uwo-fast/OpenReactor/(commit log)

2021-07-27 updated README for raspberry pi stuff
2021-07-27 Added test.py, a temporary file to test the i2c library.
2021-07-27 created test scripts for reading sensors
2021-07-28 added print functions and then some sensor class testing
2021-07-28 testing db connections half fix
    [sensor.py]
2021-07-29 FIrst fix to graphs, basic functionality added
    [app.py]
2021-08-11 added cad to repo, setup script, updated readme
    [coolingBracket.scad, gasRelease.scad, lid.scad]
2021-08-13 Added cad
    [coolingBracket.scad, coolingBracket.stl, gasRelease.scad, gasRelease.stl]
2021-08-13 rewrote tube connection nipple funciton using bosl
    [gasRelease.scad, gasRelease.stl, lid.scad]
2021-08-14 Graphs can now be added to the graphing page using a button, added new functions in app.py to achieve this and rewrote essentially all of graphs.html.
2021-08-17 updated cad
    [lid.scad, lid.stl, nipple.scad, old_lid.scad]
2021-08-26 Started working on adaptive control code, partially working but had issues with database.
    [app.py, sensor.py]
2021-09-13 Added threading to lib, first design for one way gas release valve
    [holderCylinder.stl, lid.scad, lid.stl, release.stl, threadtest.scad]
2021-09-15 Changed pathing for 'model' hopefully to avoid issues with local imports, removes compatability with windows systems due to requirement of sensor.py
    [app.py, sensor.py]
2021-09-26 Remade the gas release valve.
    [lid.scad, release.stl]
2021-10-01 Added truncation to the floats passed to control interface -May consider adding this to any data retrieval from db to reduce json size if that becomes an issue
    [app.py]
2021-10-19 Pushing local edits, fixing file pathing still
    [app.py, sensor.py]
2022-01-18 Added built in detection of connected I2C devices on launch, started work on integrating measurements and control systems.
2022-01-18 Fixed some issues with control, still need to fix CSS and live updating for control mechanisms
    [app.py]
2022-02-01 Fixed format and functionality of controls page, control states now write correctly to DB Please enter the commit message for your changes. Lines starting
    [app.py, device_detect.py, sensor.py, sensor_format.py]
2022-02-21 Added PCB file for multispectrum LED
    [laser.kicad_pcb, laser.kicad_sch, multispectrum LED.kicad_pcb, multispectrum LED.kicad_sch, relay.kicad_pcb, relay.kicad_sch]
2022-02-23 Added second current source and breakout for laser. Need to switch outputs of relays.
    [relay.kicad_pcb]
2022-02-28 updated PCB for relay
    [relay.kicad_sch]
2022-03-06 First Version of Optical Density source finished, swithced to a pin out connection for multispectrum LED.
    [laser.kicad_pcb, laser.kicad_sch, multispectrum LED.kicad_sch, relay.kicad_pcb, relay.kicad_sch]
2022-03-10 Completed implementation of cycle control, experiments can now be created, started, stopped, downloaded, and deleted entirely from the web UI. Experiments are defined as JSONs that contain a name, st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
2022-03-12 Improved documentation & layout
    -Fixed some issues that arose with graphing due to experiment selection
    -Began to properly document both front and backend code.
    -Changed order of navbar links
    [app.py, sensor.py]
2022-05-23 Implemented Threading for data aquisition Combined data aq. with existing experiment cycle Added tables to db for controls TODO ------- Fix control landing page, due to changes it doesn't load atm Im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
    [app.py, cycle.py, device_detect.py, sensor.py, sensor_format.py]
2022-05-24 Reworked structure of database for controls. Now has ControlReadings. Everything beyond if it's enabled and it's value are stored as a json in the db. Fixed controls html, now displays all controls a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
    [app.py, device_detect.py, sensor.py]
2022-06-01 Fixed issue with loading entire db table that caused massive lag. Fixed updating of user values in interfaces.
    [app.py, sensor.py]
2022-06-01 Started device config for JSON
2022-06-01 Adding Basic documentation First attempt at setup for BREAD Slice - Relay Heating Element Controller
2022-06-22 Added param for byte type to sensor.controlMessage, added outputType to __init__ of control functions
2022-06-23 Added traceback to threading try/except loop
2022-06-23 possible fix, may just break other things
    [sensor.py]
2022-06-23 updated motor II code to match I
2022-06-23 Removed legacy openSCAD files
    [coolingBracket.scad, coolingBracket.stl, gasRelease.scad, gasRelease.stl, holderCylinder.stl, lid.scad, lid.stl, nipple.scad]
2022-06-26 First attempt at getting control systems to reset to initial paramters on shutdown/disable
    [app.py]
2022-06-28 possible fix to experiment stop
    [app.py]
2022-07-29 Added experiment thread cycle time management
2026-10-03 chore: rename the project from Loafware to OpenReactor (#3)
    The repository is now uwo-fast/openreactor. Replace the Loafware name
    in the README, the web interface (page title, navbar, landing page,
    about page), the npm package metadata and the LICENSE notice.
    The README's install steps and the about page linked to
    github.com/FEASTorg/loafware, which does not exist; they now point to
    this repository. The about page's first paragraph also lost the words
    "written in" before its list of libraries; they are restored.
    The database file keeps its name, loafware.db, so an existing install
    keeps its data after updating. A comment in config.py records why.
2026-10-03 fix(sensors): timestamp control parameter edits and resets (#4)
    I2C.edit_params() and reset_control() stored the new parameters with
    self.time, which only controlMessage() updates. So an edit was stored
    with exactly the timestamp of the row before it. The control plugins
    read their current parameters with ORDER BY time DESC, and SQLite
    does not define which of two tied rows that returns, so a change made
    from the web interface could be ignored.
    It could also undo changes to closed-loop controls: the heater and pH
    PID plugins call edit_params() from process(), so on a tie they could
    read the old parameters and store them back over the change.
    Both methods now take a fresh timestamp before s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
    [sensor.py]
2026-10-03 feat(controls): apply safe control changes immediately (#5)
    A change posted from the web interface used to be stored and then
    wait for the next experiment-thread cycle, or forever if no
    experiment was running. It is now sent to the slice straight away
    when that is safe:
    - Disabling a control always resets it at once, so switching off a
    heater or pump takes effect even with no experiment running.
    - Enabling or retuning a control applies at once only if its plugin
    sets APPLY_ON_CHANGE = True. The two motor plugins do, as their
    output is just the requested speed. The heater and pH PID plugins
    do not: they integrate on every call and need fresh sensor readings,
    so they stay with the e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
    [device_detect.py, sensor.py]
2026-10-03 fix(sensors): read the whole EZO reading (#7)
    The "atlas" formatter kept only the four characters after the status
    byte, so every EZO reading longer than four characters was cut short:
    7.012 became 7.01, -123.4 became -123, and an EC reading of 12880
    became 1288, ten times too small.
    It now takes the leading number after the status byte. That stops at
    the NUL terminator, at any padding after it, and at the comma when a
    multi-output circuit such as EC sends several values, of which the
    first is the primary reading.
    [sensor_format.py]
2026-10-03 fix(maths): stop the calibration parser from hanging (#8)
    The parser turns implicit multiplication such as 2x or 2(x+1) into
    2*x and 2*(x+1), but its regular expressions only matched the digits
    1-9 before x or "(". A coefficient ending in 0 was left as "10x":
    10x+0, 20x+1 and 0x+7 hung forever, and 100x, 10(x+1) and 1.50x
    raised errors. Both expressions now match any digit.
    Other input the solver could not reduce also hung it, including
    equations with spaces (2x + 1) and malformed ones such as 2x2 or
    x+-1. Spaces are now removed before parsing, and a pass over the
    equation that changes nothing raises ValueError instead of looping.
    The hang mattered most because readings are calibrated whil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
2026-10-03 fix(app): hold dataLock for control changes and manual reads (#9)
    The experiment thread holds dataLock for each cycle, but the routes
    that change control state or use the bus did not take it:
    - A parameter change posted from the controls page could land while
    a heater or pH PID plugin was between reading its parameters and
    storing them back, and the plugin then wrote the old parameters
    over the change.
    - The Reset button changed parameters the same way.
    - A manual sensor read could use the bus during a cycle.
    These routes now hold dataLock, and applyControlChange() expects its
    caller to hold it. A change may now wait for the current cycle to
    finish.
    Stopping an experiment had a rela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
2026-10-03 fix(app): make Reset and Stop reach the outputs (#10)
    The Reset button restored each control's default parameters in the
    database but never wrote to the bus. With no experiment running, a
    heater or pump kept its last output after Reset. Reset now applies
    the reset to each control straight away, under dataLock, by the same
    rules as a change from the controls page: a disabled control gets its
    reset output, and an enabled closed-loop control is left to the
    experiment cycle.
    Stopping before any experiment had started raised AttributeError,
    because the initial thread handle was a threading.Thread, which has
    no cancel(). Pressing End in that state returned an error and left
    the outputs as they we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
2026-10-03 fix(sensors): ignore EZO responses without a new reading (#11)
    The "atlas" formatter never looked at the EZO status byte. If a
    "still processing" response (254) carried text, such as the previous
    reading left in the buffer, that text was stored as a new reading.
    "No data" (255) and "syntax error" (2) produced text that failed to
    convert and was dropped with an error.
    Only status 1 (success) now yields a reading. Anything else prints
    the status and returns None, which store() already skips. The status
    byte is masked like the text bytes, so a success byte with the high
    bit set still counts.
    [sensor_format.py]
2026-10-03 fix(maths): compute calibration equations correctly (#12)
    The hand-written equation solver got several kinds of equation wrong:
    - It did every addition before any subtraction, so x-1+2 was
    computed as x-(1+2).
    - A number minus x was treated as x minus the number: 3-x gave x-3.
    - A number divided by x was treated as x divided by the number,
    though it is not a linear calibration at all.
    - A leading minus (-2x+3, -x) raised an error.
    parse() now reads the equation with Python's own expression parser
    and evaluates it as a linear function m*x + b. It allows numbers, x,
    + - * /, unary minus and brackets, with implicit multiplication such
    as 2x, 2(x+1), x(2) and (x+1)2. Input longer than 100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
2026-10-03 fix(app): reject calibration equations that do not parse (#13)
    /controls/calibrate saved whatever text it was sent. An equation the
    parser could not use (x*x, x/0, abc) was stored and then failed on
    every reading of that sensor, and a constant such as 5 was accepted
    although it would replace every reading with that constant.
    The route now parses the equation first and saves it only if it
    evaluates to a number with x as the variable and depends on x.
    Otherwise it returns 400 and keeps the previous equation, and the
    settings dialog shows "Invalid equation, not saved" instead of
    closing. The dialog also gains a Cancel button, since a successful
    save was the only way to close it.
2026-10-03 fix(app): run only one experiment loop at a time (#14)
    Starting an experiment while one was already running started a
    second timer loop, so every cycle then ran twice, reading every
    sensor and writing every control twice as often. A related race let a
    cycle from a stopped loop keep going: if its timer had already fired
    and was waiting for dataLock when Stop and a new Start came in
    quickly, it ran alongside the new loop and rescheduled itself.
    experimentThreadStart() now does nothing if a loop is already
    running, and checks and starts under dataLock. Each start also bumps
    a loop generation that its cycles carry, and a cycle from an older
    generation returns without doing anything. The experim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
2026-10-03 build(deps): update the web stack and drop unused packages (#15)
    requirements.txt pinned the 2021 releases of Flask 2.0.1, Werkzeug
    2.0.1, Jinja2 3.0.1 and wheel 0.36.2, which all have published
    security advisories. The Werkzeug fixes are only in 3.x, which needs
    Flask 3, so the web stack moves to current releases: Flask 3.1.3,
    Werkzeug 3.1.9, Jinja2 3.1.6, MarkupSafe 3.0.4, itsdangerous 2.2.0,
    click 8.1.8 and blinker 1.9.0, which Flask now requires. All support
    Python 3.9 and later; click stays on 8.1 because 8.2 needs 3.10. On
    Python 3.9, Flask also needs importlib-metadata, which brings in
    zipp; both are pinned for that version only.
    The app only uses Flask, render_template, request and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
2026-10-04 fix(experiments): stop shipping a running sample experiment (#30)
    experiments/test.json was a sample experiment saved with "running": 1.
    At startup the app resumes every experiment marked running, so every
    fresh install started the experiment loop on import, recording to an
    experiment nobody had created.
    The file is removed, so a fresh install starts idle, and experiment
    records written at runtime (experiments/*.json) are now ignored by git
    so one cannot be committed again.
2026-10-04 feat: replace the 1.x code with the 2.0 config and CLI (#36)
    Remove the 1.x application from main: app/, sensors/, controls/,
    database/, experiments/, run.py, config.py, requirements.txt,
    first_time_setup.sh, start.sh and devices.json. It stays on the 1.x
    branch and its tags.
    Add the TOML configuration model (stdlib tomllib). Validation rejects
    duplicate bus and address pairs, unknown kinds, addresses outside 0x08
    to 0x77, a name used twice (device and channel names share one
    namespace, since an EZO device is itself a channel), a temp_comp that
    does not name an ezo-rtd device, a watchdog timeout outside
    3 x slice_poll_s to 65535 ms, and an ezo_period_s below the slowest
    EZO read plus 0.2 s.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
    [device_detect.py, sensor.py, sensor_format.py]
2026-10-04 ci: publish releases to PyPI with Trusted Publishing (#38)
    A v* tag that matches the pyproject.toml version builds the wheel and
    sdist, publishes them from the pypi environment with Trusted
    Publishing (no API token), then creates the GitHub release with the
    distributions and a constraints.txt from uv.lock. Versions with a, b
    or rc are marked as pre-releases.
    Running the workflow by hand dry-runs the same build against TestPyPI
    from the testpypi environment.
    Part of #20.
2026-10-04 build: allow uv_build 0.12 (#37)
    Widen the build backend pin from >=0.11,<0.12 to >=0.11,<0.13.
2026-10-04 build: pin uv to the uv_build range in CI and locally (#39)
    setup-uv installed the newest uv (0.12.23 for v2.0.0a1), which built
    with its own backend although build-system.requires said
    uv_build<0.12, and only warned. setup-uv reads tool.uv.required-version
    from pyproject.toml, so CI now installs the newest uv inside the same
    range as the build backend, and a local uv outside it refuses to run.
2026-10-04 feat(ezo): read and calibrate EZO circuits from the CLI (#40)
    Add the Atlas EZO pH, ORP, RTD, EC, DO and HUM circuits over
    ezo-driver, behind a small EzoPort protocol so tests can use a fake.
    - At startup each circuit's reported type is checked against the
    config, and the output masks of DO, EC and HUM and the RTD scale are
    cached. A circuit of the wrong type is disabled and reported.
    - Reads are split-phase: every read is sent, then each circuit is read
    when its own delay is up. pH, EC and DO compensate with the last RTD
    temperature, converted to Celsius; a failed RTD read, or the RTD's
    no-probe value of -1023, clears it, and the reading says so. A
    NOT_READY circuit is read aga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
2026-10-04 feat(controller): one bus owner with a tick, stop-all and a lock (#41)
    Add the controller every device command goes through:
    - A 100 ms tick on a monotonic clock, at start + n x 100 ms so it never
    drifts. A tick never sleeps or waits on a device: it drains a command
    queue, resumes EZO commands that are due, and starts and collects the
    split-phase EZO reads.
    - Stop-all runs on the next tick and sends every actuator its safe
    state before reporting anything; a failing actuator, a failing
    listener or an interrupt never skips the others, and listener errors
    are isolated. The slices add actuators in #24 and #25.
    - EZO commands are step generators the controller resumes on later
    tick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
2026-10-04 docs(bench): prepare a Pi for the bench checks (#42)
    How to enable I2C, switch the EZO circuits to I2C mode and find them at their default addresses, install from a checkout while ezo-driver builds from source, check a config, and check that the controller lock holds across users.
2026-10-04 feat(storage): record runs, readings and events in SQLite (#43)
    - A Store over stdlib sqlite3 in WAL mode, with the schema version in
    PRAGMA user_version; another version is refused. Tables: channels,
    runs (running, completed, stopped or interrupted, with a config
    snapshot), readings (each with its unit), events and profiles. The
    schema is created under BEGIN IMMEDIATE, so first opens do not race.
    - A Recorder subscribed to the controller writes on its thread, the
    database's only writer. Each reading is one transaction; failed reads
    and non-finite values become events. While recording, a write waits
    at most 50 ms for a lock. A failed write is logged, stops recording
    and marks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
2026-10-04 feat(web): serve the controller over an authenticated HTTP API (#45)
    openreactor serve runs the controller in a FastAPI app's lifespan, one
    process and one worker, holding the controller lock and binding the
    port before any device opens. /api/v1 covers status, channels,
    setpoints (409 until the slices land), stop-all, runs and export, and
    EZO calibration, through a service layer that never touches the bus.
    A timed-out action is cancelled, never run late; circuit refusals are
    502 and storage failures 503.
    Without server.password_hash, serve binds only to loopback and answers
    only loopback Host names. With one, a browser signs in at POST /login
    for a revocable signed session cookie and a scri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
2026-10-04 fix(serve): exit cleanly on Ctrl-C (#46)
    uvicorn re-raises Ctrl-C after a clean shutdown; serve, which calls Server.run itself to bind the port first, let the KeyboardInterrupt through as a traceback and exit 130. It now exits 0.
2026-10-04 build(deps): take ezo-driver 0.6 from PyPI (#49)
    ezo-driver 0.6.0 is on PyPI with cp39-abi3 wheels for x86_64 and aarch64; the git pin goes, capped below 0.7, and a Pi installs with no compiler. Tested wheel-only (uv sync --no-build-package ezo-driver): 326 passed.
2026-10-04 feat(ui): serve an operator UI that works offline (#50)
    openreactor serve now serves the operator's UI at /: server-rendered
    Jinja2 pages with htmx partials. A dashboard with live values and a
    chart per channel (a gap for a failed read), controls with a setpoint
    per actuated channel, runs (start, stop, export), EZO calibration with
    Calibrate and Clear behind a confirmation, and an about page with the
    AGPL notice and the vendored packages. Stop all is on every page, and a
    stop-all where any output failed shows as a red failure naming it. The
    footer gives the version and the source link.
    Pages and actions use the same service layer and sign-in as /api/v1:
    pages send a stranger to a sign-in fo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
2026-10-04 feat(rlht): start RLHT slices safely and keep their watchdog fed (#52)
    run and serve start each RLHT heater slice over CRUMBS (crumbs-i2c
    0.15, bread-crumbs-contracts 0.5); read and ezo cal never touch one.
    Start-up checks the reply's type, CRUMBS 0.12.0 or later and the
    module version, reads caps, sends the safe state (SET_SETPOINTS(0, 0)
    then SET_OPEN_DUTY(0, 0), both always), arms and confirms the command
    watchdog when the slice has one (read-only otherwise, unless
    allow_unprotected), then sets closed-loop mode, the thermocouples and
    any configured periods and gains.
    Gains are never filled in: check-config takes kp, ki and kd only on a
    channel for each output or on none, and refuses ki =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
2026-10-04 feat(rlht): supervise slices for trips, reboots, e-stops and silence (#54)
    ## Description
    This is the second of three parts of #24. A running RLHT slice is
    supervised: openreactor notices a watchdog trip, a reboot, an e-stop or
    a silent bus, logs it, and puts the slice back the way the config and
    the operator left it. Setpoints from the API and UI follow in part 3.
    **The cycle.** Each `slice_poll_s` slot reads GET_STATE, split across
    two ticks so a tick never waits. After every fifth state poll, the same
    cycle also reads GET_WATCHDOG on the next tick.
    **Trips and reboots.**
    - A reboot is the watchdog reading disarmed.
    - A trip is the tripped flag, or a trip count that changed. A count
    bel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
2026-10-04 feat(rlht): set slice setpoints from the API and the controls page (#56)
    Part 3 of #24, first half: an operator can now set an RLHT channel's
    setpoint. A follow-up PR adds `openreactor status`.
    **Setting it.** `PUT /api/v1/channels/<name>/setpoint` or the Controls
    page. The value is in °C, rounded to the slice's tenth of a degree, and
    goes to the slice at once from the controller's thread. It becomes the
    desired setpoint, which a re-assert sends again, only once the slice has
    it. Stop-all or an e-stop zeroes it, and a restart never restores it.
    Each setpoint sent or tried is an event in the run.
    **Refused, with nothing sent:**
    - **422:** below 0, not a JSON number (`true`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
2026-10-04 feat(cli): show each RLHT slice's state with openreactor status (#57)
    Part 3 of #24, second half: `openreactor status` shows each RLHT slice's
    state.
    ```
    $ openreactor status
    heater 0x0A RLHT 1.0.0, CRUMBS 0.15.0
    watchdog armed 5000 ms, trips 0
    e-stop clear
    mode closed loop
    jacket 37.4 °C setpoint 37.0 duty 22 % tc 1
    output 2 no reading setpoint 0.0 duty 0 % tc 2
    (from the server at http://127.0.0.1:8080/api/v1/status)
    ```
    **Only from a running server.** status asks the server's
    `/api/v1/status`, at the config's `[server]` address or `--url`. A
    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
2026-10-04 docs(readme): say which slice firmware stop-all turns a heater off on (#58)
    The README said stop-all decays a running heater "until
    feastorg/Slice_RLHT#13 is fixed". #13 is now fixed and closed, in
    Slice_RLHT 16a04dd, so the sentence read as if every slice now stops at
    once.
    In fact a slice keeps decaying until it is flashed with 16a04dd or
    later, and openreactor can't tell the two apart: the version reply is
    the same for both (feastorg/bread-crumbs-contracts#23). The README now
    says so. It also says the fix has been checked on the host: the on-time
    is 0 at the next control step. On a relay it is still unchecked; that is
    the `docs/bench.md` row for #51.
    Part of #51
    ## Type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
2026-10-13 docs(bench): record the first rig's bench results (#63)
    A gen1 RLHT with no heater on the relay, two gen1 DCMTs, EZO pH and DO,
    no RTD. The watchdog, stop-all from every route and the run export pass.
    Releasing an e-stop that cuts backplane power resumes the relay at its
    old setpoint (#62). EZO calibration and the CLI run are not yet run, and
    the profile check waits on #28.
2026-10-13 docs(bench): set the Pi 4's I2C rate and core clock in Pi prep (#64)
    A Pi 4 needs `dtparam=i2c_arm_baudrate=50000` and `core_freq_min=500` in
    `config.txt` for the slices to answer reliably, as the CRUMBS platform
    setup documents. The first bench rig ran with both.
2026-10-13 fix(rlht): keep setpoints at zero after a slice reboots (#65)
    A slice reboots when its power is cut, and on a rig whose e-stop cuts
    the backplane's power that is what releasing the e-stop looks like. The
    re-assert sent the setpoints the slice had before, so the heater came
    back on with no operator action.
    A reboot (the watchdog disarmed), or a trip count that went down (a
    build that arms at boot, or the counter wrapping), now re-asserts mode,
    thermocouples, periods, gains and the watchdog, with the setpoints at
    zero until the operator sets them again. A trip with the slice powered
    throughout still restores them.
    Closes #62
2026-10-13 fix(config): report an integer too large for a float as a problem (#67)
    TOML integers have no size limit. A period, `max_setpoint` or PID gain
    too large for a float raised `OverflowError` from `math.isfinite`, and
    `check-config` ended in a traceback instead of listing the problem. Such
    a value is now "must be a finite number" (or out of range, for gains),
    as profile validation already does.
2026-10-13 docs(src): rewrite comments and docstrings in the core modules (#70)
    Comments and docstrings only, in `rlht.py`, `controller.py`, `cli.py`,
    `config.py` and `lock.py`; no code changes (the modules' ASTs with
    docstrings removed are identical to `main`).
    - Docstrings are full sentences with a one-line summary, and predicates
    say what they return.
    - Issue numbers used as justification are replaced by the reason itself.
    - `rlht.py`'s module docstring is short; the start-up order moved to
    `start()`, the safe state to `send_safe()`, and the poll and keep-alive
    to the poll.
    - Stale comments now match the code: what `UNREACHABLE_AFTER` counts,
    when the watchdog is checked, the third case `SliceBusy`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
2026-10-13 fix(cli): say why read skips slices (#71)
    read printed "slices are not read yet", as if a later version would read
    them. read covers EZO circuits by design: reading a slice feeds its
    watchdog, and run and serve already poll the slices.
2026-10-13 docs: reorganise the README and split the docs by task (#72)
    The README was a 236-line behaviour spec, and installing on a Pi was
    documented only inside the release checklist. The README is now a short
    front page (what openreactor is, its status, hardware, quick start and a
    docs index), and the detail moved into task pages:
    - `docs/install.md`: preparing a Pi (I2C, the Pi 4 clock lines, EZO I2C
    mode and addresses) and installing openreactor.
    - `docs/configuration.md`: each section and key, with defaults and
    limits from `config.py`.
    - `docs/usage.md`: the commands, the controller lock, runs and export,
    `status`, profiles and calibration.
    - `docs/web.md`: the browser UI, the HTTP API with its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
2026-10-13 docs(src): rewrite comments and docstrings in the app modules (#73)
    Comments and docstrings only, in `service.py`, `web.py`, `ui.py`,
    `ezo.py`, `storage.py`, `profile.py` and `auth.py`; no code changes (the
    modules' ASTs with docstrings removed are identical to `main`), and the
    OpenAPI document is byte-identical.
    - Docstrings are full sentences with a one-line summary.
    - Stale comments now match the code: the profile validator serves only
    the CLI; the CLI runs EZO calibration through `controller.run_job`, not
    `run_steps`; `StorageError` lists all four causes; `Conflict` covers a
    slice that is e-stopped or read-only as well as a run already recording;
    and the database's `check_same_thread` c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
2026-10-13 build: lint and type-check scripts/ (#74)
    `scripts/vendor.py` downloads and writes the vendored browser files, but
    ruff, pyright and the pre-commit ruff hooks covered only `src/` and
    `tests/`. They now cover `scripts/` too. pyright found one error:
    `__doc__` may be `None`, so the script takes its first line with
    `(__doc__ or "").partition("\n")[0]`; `--help` prints the same.
    The justfile drops `set dotenv-load := false`, which has been just's
    default since 0.11.0.
2026-10-13 refactor(rlht): build slice events in one place (#75)
    No behaviour changes.
    - `RlhtSlice._event()` builds every run-log event the slice emits, in
    place of nine copies of `Event(self._wall(), "system", ...,
    device=self.name, ...)`. Recording every event across the test suite
    before and after gives identical logs (275 events, wall-clock time
    masked).
    - `CrumbsPort.stage` uses crumbs-i2c's `TYPE_ID_ANY` and `SET_REPLY`
    instead of `0x00` and `0xFE`; `_query`, which only wrapped `port.query`,
    is inlined; the start-up event reuses the version string.
    - `ezo.py` no longer ships `run_steps`, `calibration_status`,
    `calibrate`, `clear_calibration` or `EzoReader.next_due`, which only the
    tests used; t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
2026-10-13 chore: trim .gitattributes and remove the 1.x planning files (#79)
    - `.gitattributes` keeps only `* text=auto eol=lf`. The rest repeated
    that rule type by type for the text files here, and listed many types
    the repo does not have (KiCad, CAD, firmware, Office). `git add
    --renormalize` over every tracked file with the new rules changes
    nothing.
    - `docs/planning.md`, the 1.x notes on scripting experiments, is now
    #78.
    - `docs/start_diagram.drawio` drew the 1.x start-up scripts
    (`first_time_startup.sh`, `start.sh`, `run.py`), which no longer exist.
    Nothing linked to it. It also had no final newline, so `pre-commit run
    --all-files` failed on it.
2026-10-13 docs(development): add a diagram of how the modules fit together (#80)
    Adds "How the code fits together" to `docs/development.md`: a mermaid
    flowchart from the browser, scripts and CLI down to the I2C bus and
    SQLite, with short notes on which thread owns the bus and the database,
    where `security.py` and `errors.py` sit, and what `lock.py` prevents.
    It replaces the 1.x drawio removed in #79. GitHub renders mermaid in
    place, so the diagram is plain text in the doc, and a diff shows each
    change to it.
    The rendering has not been viewed yet; the file view on this PR shows
    it.
2026-10-14 docs(bench): record the e-stop, reboot, run and lock checks on 1018584 (#81)
    Bench results on rig 1 at `main` 1018584, for the rows that were pending
    since #62 and #65.
    - **E-stop that cuts backplane power:** now a pass. At a 35 °C setpoint,
    release gave `slice-reboot` `re-asserted` and the relay stayed off.
    - **Slice reset:** passes twice. The second time, a status read 1 s
    after the event showed closed loop, thermocouple 1, a 1000 ms period,
    the watchdog armed at 5000 ms and the setpoint at 0. A new setpoint
    turned the relay on again.
    - **CLI run and export:** a 28 s run ended `stopped` on Ctrl-C; `export`
    wrote 129 readings, two events and `run.json`. The API run passes again
    on this co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
2026-10-14 build(deps): require bread-crumbs-contracts 0.6 (#84)
    Raises the pin to `bread-crumbs-contracts>=0.6,<0.7` (0.5.0 → 0.6.0 in
    `uv.lock`).
    0.6.0 only adds to 0.5.0, by a diff of the two wheels' modules:
    - `BREAD_OP_CLEAR_WATCHDOG_TRIP` (0x7C, empty payload), with
    `rlht_send_clear_watchdog_trip()` and `dcmt_send_clear_watchdog_trip()`;
    - `RLHT_CAP_CLEAR_WATCHDOG_TRIP` (bit 7) and
    `DCMT_CAP_CLEAR_WATCHDOG_TRIP` (bit 6), which a slice advertises when
    its watchdog trip latches until cleared;
    - docstrings. No existing constant, payload or parser changed.
    The bench rig's DCMTs run Slice_DCMT 44966b3, whose trip latches and
    which advertises the flag, so driving them (#25) needs the clear op.
    `ju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
2026-10-14 fix(config): allow PID gains on a gen1 RLHT's only channel (#85)
    A gen1 RLHT has one relay, and `check-config` refused gains unless a
    channel set them for both outputs, so the bench config needed a
    placeholder channel on output 2.
    - **The rule:** gains go on every channel of the device or on none. Two
    channels with gains on only one are still refused:
    device[0].channels: gains (kp, ki, kd) must be set on every channel or
    on none: the slice sets both outputs' gains at once, and an output with
    no channel gets the other output's gains
    - **What goes to the slice:** SET_PID still carries all six gains. An
    output with no channel gets the configured channel's `kp`, `ki` and
    `kd`, whic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
2026-10-14 feat(dcmt): add a DCMT slice that drives its motors open loop (#86)
    The first half of #25: `src/openreactor/dcmt.py`, a `DcmtSlice` that
    starts, polls and supervises one DCMT slice. Nothing creates one yet.
    Wiring it into `serve`, `run`, the API and the UI follows in a separate
    PR.
    Each motor runs open loop at a PWM from -255 to 255; 0 brakes it. The
    slice's position and speed loops are not used.
    - **Start-up:** the version must be DCMT 1.x on CRUMBS 0.12 or later,
    and the caps must offer open loop and brakes. Then the safe state,
    brakes on, open loop and PWM 0, in that order: a slice in closed-loop
    position keeps driving until it is braked. Then the watchdog is armed
    and confirmed. A slic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
2026-10-14 docs: write down the 2.0 scope and the 1.x rules (#83)
    - **README, Scope:** one bench-top vessel per instance, every device in
    the config. Not included: plugins or user scripts (ideas for after 2.0
    are in #78), device discovery, a simulator, mechanical processing, 1.x
    data migration. EZO-fed host loops such as dosing come in 2.1.
    - **README, Status:** the `1.x` branch takes fixes for reported bugs
    only, and issues fixed there are closed by hand. Until 2.0.0, an
    unpinned `pip install openreactor` gets the alpha: `pip download
    openreactor --no-deps` on 2026-10-13 fetched
    `openreactor-2.0.0a1-py3-none-any.whl`.
    - **configuration.md:** only an `ezo-rtd` device can be a temperature
    compensation s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
2026-10-14 fix(rlht): read the slice before sending a setpoint (#89)
    SET_SETPOINTS carries both outputs' setpoints, so setting one output
    sends the other's again. After a reboot that no poll had seen yet, that
    restarted the other heater with the watchdog disarmed until the next
    watchdog check. The likeliest cause is a power-cut e-stop released and a
    setpoint set straight after.
    Reproduced on the fake slice before the fix: output 2 at 60 °C, a
    reboot, then a setpoint on output 1:
    after set on output 1: setpoints [400, 600] armed 0
    output 2 back to 0 after 3.4 s; events: [('slice-reboot', 're-asserted')]
    The same gap came up in the DCMT review (#86), where it is fixed the
    same way.
    - **Befor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
2026-10-14 feat(dcmt): drive DCMT motors from serve, run, the API and the UI (#88)
    The second half of #25, after #86: DCMT slices in the config are
    started, polled and stopped like RLHT slices, and driven from the API,
    the UI and `run`. (It replaces #87, closed when its base branch went
    with #86.)
    - **`slices.py`** opens both kinds on a shared bus; `opened_slices`
    moves there from `rlht.py`, unchanged for RLHT. Once the controller has
    closed normally (stop-all sent, thread stopped), `release()` sends each
    started DCMT its safe state and then disarms its watchdog. If closing
    fails or times out, the watchdogs stay armed and trip: a controller
    thread still running could otherwise drive a motor after its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
