uwo-fast/OpenReactor/(notices)

Notices in the files:
README.md:
License: AGPL-3.0-or-later
